jimbro1000/nanoSwinSIDlives/(commit log)

2023-03-03 chore: improve groundplane
    [swinsid88_smd_1_1-top.kicad_pcb]
2023-03-03 feature: hide components
    [swinsid88_smd_1_1-top.kicad_pcb, swinsid88_smd_1_1-top.kicad_sch]
2023-03-04 prettify board
    [swinsid88_smd_1_1-top.kicad_pcb, swinsid88_smd_1_1-top.kicad_sch]
2023-03-06 update component details
    [swinsid88_smd_1_1-top.csv, swinsid88_smd_1_1-top.kicad_pcb, swinsid88_smd_1_1-top.kicad_sch]
2023-03-27 use handsolder footprints
    [swinsid88_smd_1_1-top.kicad_pcb, swinsid88_smd_1_1-top.kicad_sch]
